BoredAmi/mobile_platform/ros2_ws/src/jgb_rover_gazebo/models/poster_0/materials/textures/poster_0.png

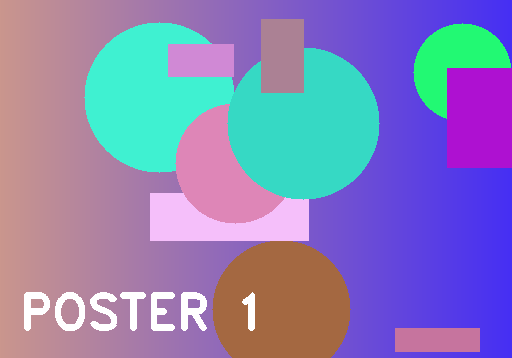
ros2_ws/src/jgb_rover_gazebo/models/poster_0/materials/textures/poster_0.png
