BoredAmi/mobile_platform/ros2_ws/src/jgb_rover_gazebo/models/poster_1/materials/textures/poster_1.png

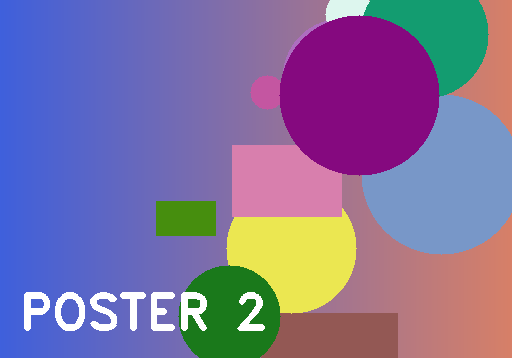
ros2_ws/src/jgb_rover_gazebo/models/poster_1/materials/textures/poster_1.png
