BoredAmi/mobile_platform/ros2_ws/src/jgb_rover_gazebo/models/poster_2/materials/textures/poster_2.png

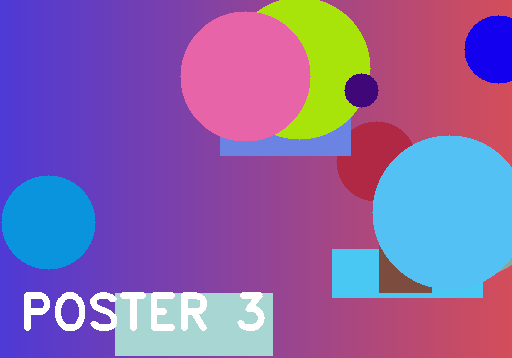
ros2_ws/src/jgb_rover_gazebo/models/poster_2/materials/textures/poster_2.png
