BoredAmi/mobile_platform/ros2_ws/src/jgb_rover_gazebo/models/aruco_marker_5/materials/textures/aruco_marker_5.png

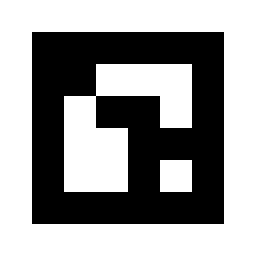
ros2_ws/src/jgb_rover_gazebo/models/aruco_marker_5/materials/textures/aruco_marker_5.png
