BoredAmi/mobile_platform/meshes/9b_realsense_d435_mount.stl

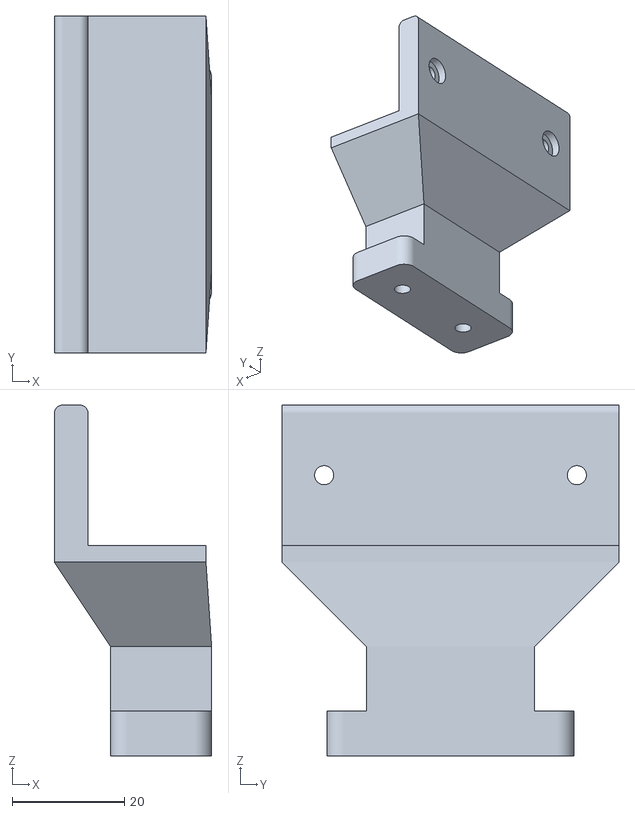
[picture p17: CAD file, 2026-11-02]
meshes/9b_realsense_d435_mount.stl
28.0 x 60.0 x 62.5
