BoredAmi/mobile_platform/ros2_ws/src/jgb_rover_description/meshes/caster_front.stl

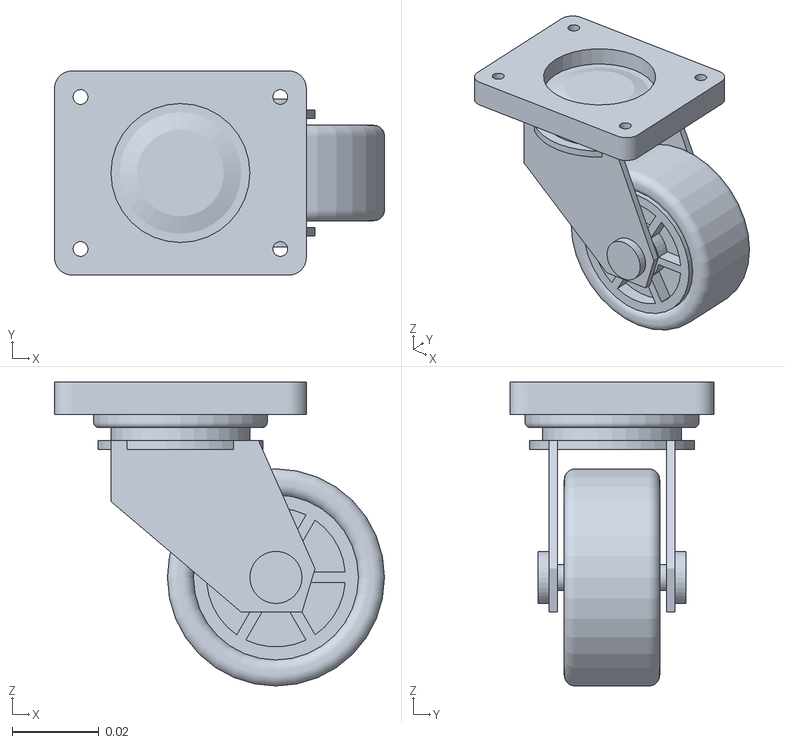
[picture p18: CAD file, 2026-10-03]
ros2_ws/src/jgb_rover_description/meshes/caster_front.stl
0.076 x 0.047 x 0.07
