BoredAmi/mobile_platform/ros2_ws/src/jgb_rover_description/meshes/drive_wheel.stl

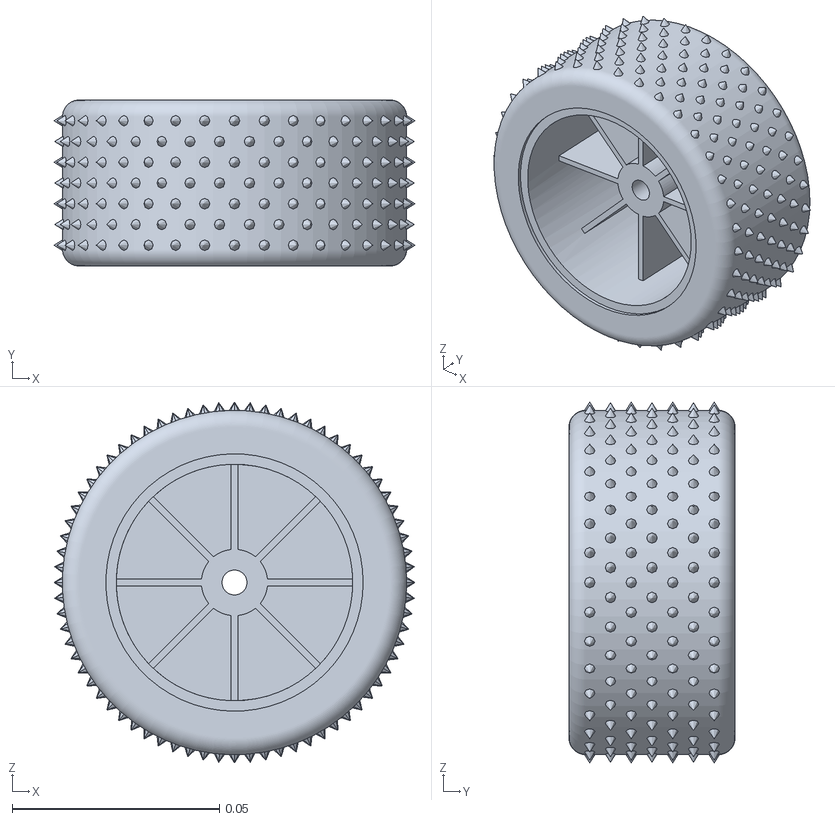
[picture p19: CAD file, 2026-10-03]
ros2_ws/src/jgb_rover_description/meshes/drive_wheel.stl
0.087 x 0.04 x 0.087
