BoredAmi/mobile_platform/ros2_ws/src/jgb_rover_description/meshes/battery.stl

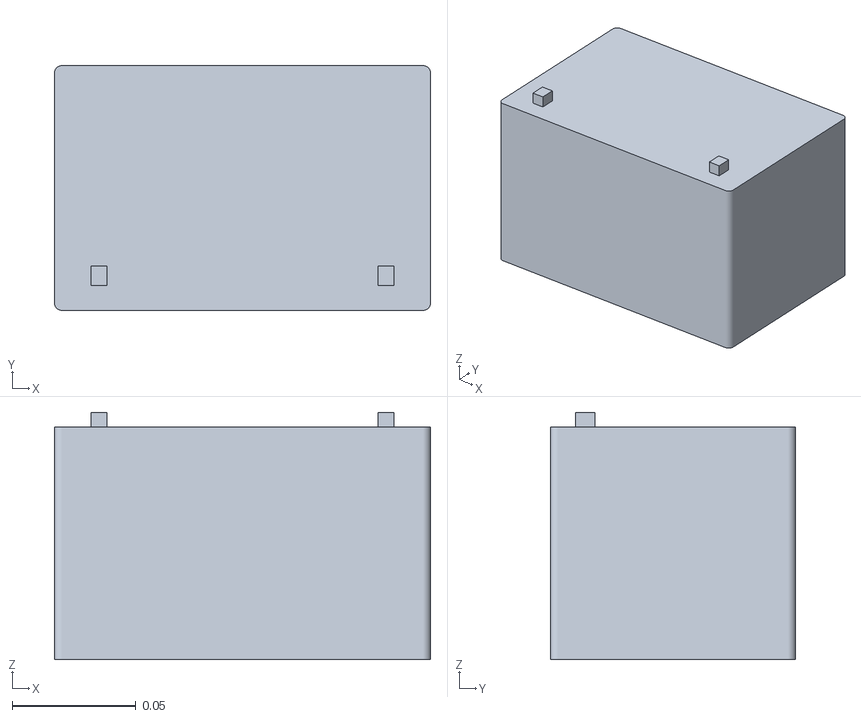
[picture p20: CAD file, 2026-10-03]
ros2_ws/src/jgb_rover_description/meshes/battery.stl
0.152 x 0.099 x 0.1
