BoredAmi/mobile_platform/ros2_ws/src/jgb_rover_description/meshes/breadboard.stl

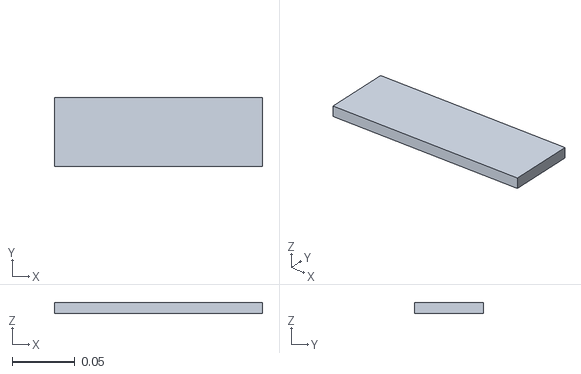
[picture p21: CAD file, 2026-10-03]
ros2_ws/src/jgb_rover_description/meshes/breadboard.stl
0.165 x 0.0546 x 0.0085
