BoredAmi/mobile_platform/ros2_ws/src/jgb_rover_description/meshes/drive_unit_right.stl

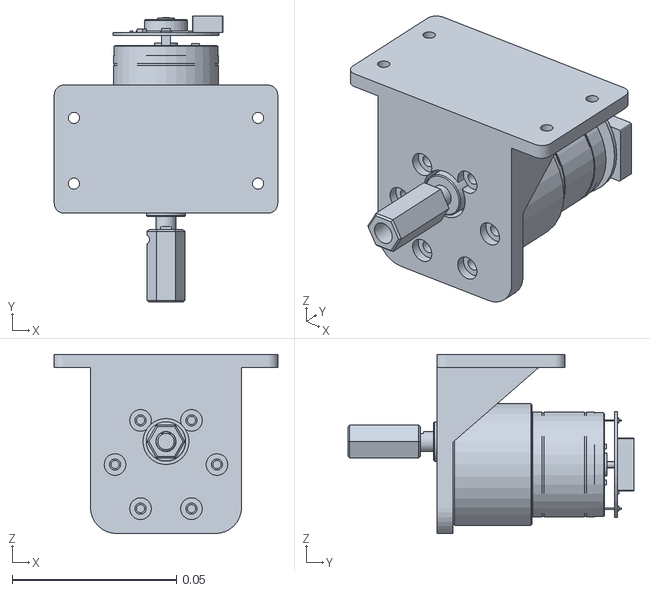
[picture p22: CAD file, 2026-10-03]
ros2_ws/src/jgb_rover_description/meshes/drive_unit_right.stl
0.068 x 0.087 x 0.0545
