BoredAmi/mobile_platform/ros2_ws/src/jgb_rover_description/meshes/webcam.stl

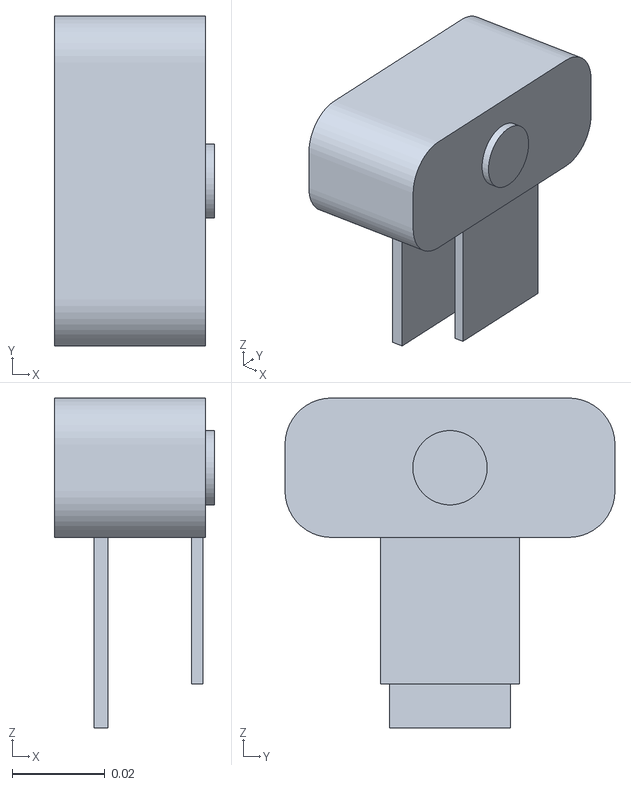
[picture p23: CAD file, 2026-10-03]
ros2_ws/src/jgb_rover_description/meshes/webcam.stl
0.0345 x 0.071 x 0.071
