BoredAmi/mobile_platform/ros2_ws/src/jgb_rover_description/meshes/chassis_printed.stl

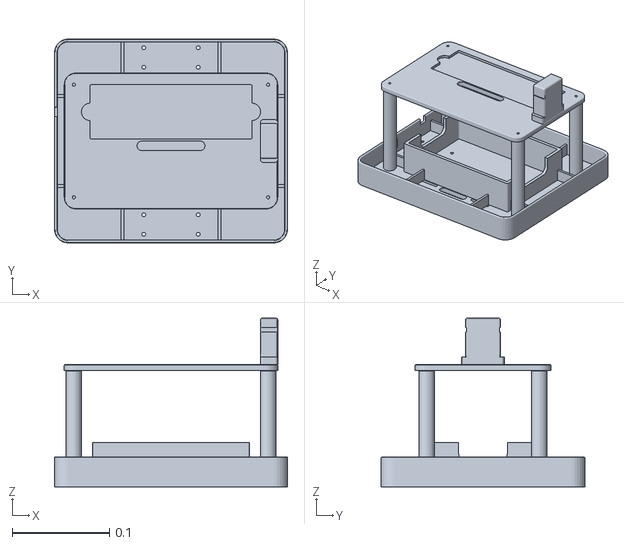
[picture p24: CAD file, 2026-10-03]
ros2_ws/src/jgb_rover_description/meshes/chassis_printed.stl
0.24 x 0.21 x 0.174
