BoredAmi/mobile_platform/(list of files, cad)

Other CAD files:
ros2_ws/src/jgb_rover_description/meshes/caster_rear.stl
ros2_ws/src/jgb_rover_description/meshes/drive_unit_left.stl
