BoredAmi/mobile_platform/results/temperature/temperature_samples.csv

t | x | y | temperature_c | raw_reading_c
2.000142857142857 | -0.1 | 0.06 | 21.294696434032925 | 21.25
2.2502500000000003 | -0.1 | 0.06 | 21.23772958740231 | 21.1875
2.5002222222222223 | -0.1 | 0.06 | 21.20834166666579 | 21.1875
3.0002222222222223 | -0.09999626534333846 | 0.060006223988721796 | 21.170836671000227 | 21.1875
3.5001111111111114 | -0.09999012917601541 | 0.06001644830680795 | 21.18888416772243 | 21.1875
4.000111111111112 | -0.09999352518437765 | 0.06001079003980227 | 21.106941671851946 | 21.125
4.500111111111112 | -0.09999523450483118 | 0.060007941777100005 | 21.094435005297164 | 21.1875
5.000111111111112 | -0.09999354594124958 | 0.060010755453461885 | 21.081926670964524 | 21.1875
5.500111111111112 | -0.09998823743280601 | 0.06001959992436485 | 21.124987501204636 | 21.1875
6.000111111111112 | -0.09999375154192501 | 0.06001041286786631 | 21.180558334074057 | 21.1875
6.5 | -0.10000003553985437 | 0.05999994076686958 | 21.193055555555567 | 21.1875
7.0 | -0.0999970438586486 | 0.06000492662716536 | 21.205555555555566 | 21.1875
7.5 | -0.09999868264452601 | 0.06000219553782488 | 21.275000000000006 | 21.25
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
