BoredAmi/mobile_platform/results/phase3/eval_odometry_nominal_win2.png

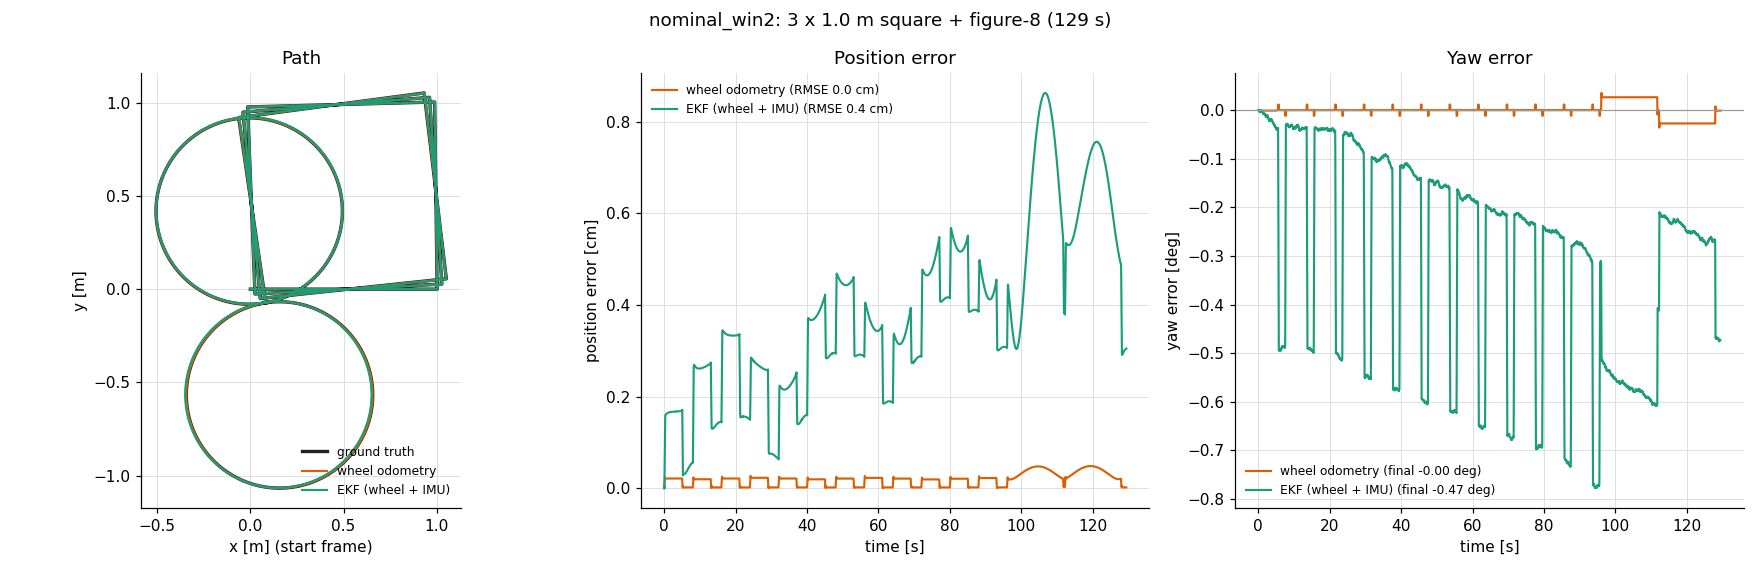
results/phase3/eval_odometry_nominal_win2.png
