BoredAmi/mobile_platform/results/phase4/slam_pose_error.png

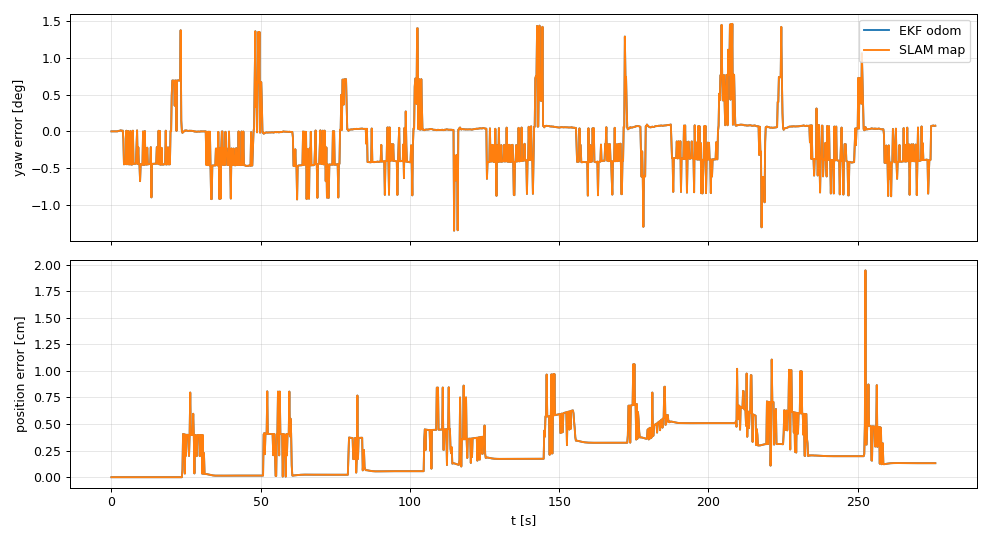
results/phase4/slam_pose_error.png
