BoredAmi/mobile_platform/results/phase4/slam_pose_error_scan_matching.png

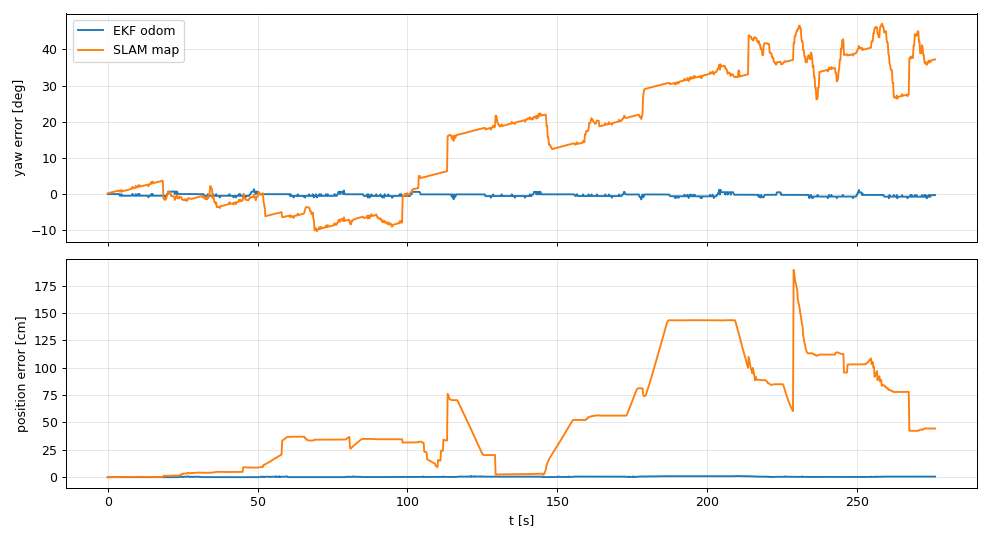
results/phase4/slam_pose_error_scan_matching.png
