BoredAmi/mobile_platform/ros2_ws/src/jgb_rover_hardware/src/serial_port.cpp

#include "jgb_rover_hardware/serial_port.hpp"

#include <fcntl.h>
#include <termios.h>
#include <unistd.h>

#include <cerrno>
#include <cstring>

namespace jgb_rover_hardware
{

SerialPort::~SerialPort() {close();}

namespace
{
// Linux speed constants for the rates a USB-UART bridge (CP210x, CH340) handles; 0 = unsupported.
speed_t baud_constant(int baud)
{
  switch (baud) {
    case 115200: return B115200;
    case 230400: return B230400;
    case 460800: return B460800;
    case 921600: return B921600;
    case 1000000: return B1000000;
    default: return 0;
  }
}
}  // namespace

bool SerialPort::open(const std::string & device, int baud)
{
  close();
  const speed_t speed = baud_constant(baud);
  if (speed == 0) {
    error_ = "unsupported baud_rate " + std::to_string(baud) + " (use 115200, 230400, 460800, 921600 or 1000000)";
    return false;
  }
  fd_ = ::open(device.c_str(), O_RDWR | O_NOCTTY | O_NONBLOCK | O_CLOEXEC);
  if (fd_ < 0) {
    error_ = device + ": " + std::strerror(errno);
    return false;
  }
  termios tio{};
  if (tcgetattr(fd_, &tio) != 0) {
    error_ = device + ": not a serial port (" + std::strerror(errno) + ")";
    close();
    return false;
  }
  cfmakeraw(&tio);
  tio.c_cflag |= CLOCAL | CREAD;
  tio.c_cc[VMIN] = 0;
  tio.c_cc[VTIME] = 0;
  // Native USB serial ignores the rate, but some magic rates reboot boards into their bootloader
  // (Teensy: 134, RP2040 / Arduino: 1200): baud_constant() only allows safe ones.
  cfsetispeed(&tio, speed);
  cfsetospeed(&tio, speed);
  if (tcsetattr(fd_, TCSANOW, &tio) != 0) {
    error_ = device + ": tcsetattr failed (" + std::strerror(errno) + ")";
    close();
    return false;
  }
  flush_input();
  error_.clear();
  return true;
}

void SerialPort::close()
{
  if (fd_ >= 0) {
    ::close(fd_);
    fd_ = -1;
  }
}

long SerialPort::read(uint8_t * buf, std::size_t len)
{
  if (fd_ < 0) {
    return -1;
  }
  ssize_t n = ::read(fd_, buf, len);
  if (n > 0) {
    return n;
  }
  if (n < 0 && (errno == EAGAIN || errno == EWOULDBLOCK || errno == EINTR)) {
    return 0;
  }
  // n == 0 on a tty in non-blocking raw mode means nothing to read, unless the device vanished;
  // an unplugged CDC device returns -1 / EIO.
  if (n == 0) {
    return 0;
  }
  error_ = std::string("read: ") + std::strerror(errno);
  close();
  return -1;
}

bool SerialPort::write(const uint8_t * buf, std::size_t len)
{
  if (fd_ < 0) {
    return false;
  }
  ssize_t n = ::write(fd_, buf, len);
  if (n == static_cast<ssize_t>(len)) {
    return true;
  }
  if (n < 0 && errno != EAGAIN && errno != EWOULDBLOCK && errno != EINTR) {
    error_ = std::string("write: ") + std::strerror(errno);
    close();
  }
  return false;
}

void SerialPort::flush_input()
{
  if (fd_ >= 0) {
    tcflush(fd_, TCIFLUSH);
  }
}

}  // namespace jgb_rover_hardware
