BoredAmi/mobile_platform/(commit log)

2026-10-03 Phase 1: Description and world
    [apartment.sdf, apartment_slip.sdf, battery.stl, breadboard.stl, caster_front.stl, caster_rear.stl, chassis_printed.stl, drive_unit_left.stl]
2026-10-03 Phase 2: ros2_control diff drive, spec-filled controller params, drive test
    [controllers.yaml, gazebo.xacro, jgb_rover.urdf.xacro, ros2_control.xacro]
2026-10-03 Phase 3: IMU, bias calibration with ZUPT, EKF fusion, error injection, odometry evaluation
    [controllers.yaml, gazebo.xacro, imu_bias_calibration.yaml, ros2_control.xacro]
2026-10-03 Phase 4: camera, visual floor scan, slam_toolbox mapping, ArUco check, map evaluation
    [gazebo.xacro, jgb_rover.urdf.xacro]
2026-10-03 Phase 5: RViz config, path display, Docker, README, lens distortion in floor scan
2026-10-04 temperature heatmap
    [jgb_rover.urdf.xacro, robot_spec.yaml, temperature_samples.csv]
2026-10-09 pi code
    [controllers_real.yaml, jgb_rover.urdf.xacro, real_hardware.yaml, robot_spec.yaml, ros2_control.xacro]
2026-10-23 move to teensy 4.1
2026-10-23 move to teensy 4.1 v2
2026-10-23 esp32 version because my teense somehow doesnt work rn
2026-10-28 for now its on laptop also camera is calibrated
2026-11-04 MCP9808 temperature on RP2040 (firmware 1.1) and D435 launch fixes
